Siegmundshof93/kicadPCBs/amurNutzlast/amurNutzlast.kicad_pcb

## KiCad design amurNutzlast/amurNutzlast.kicad_pcb (2023-10-29)

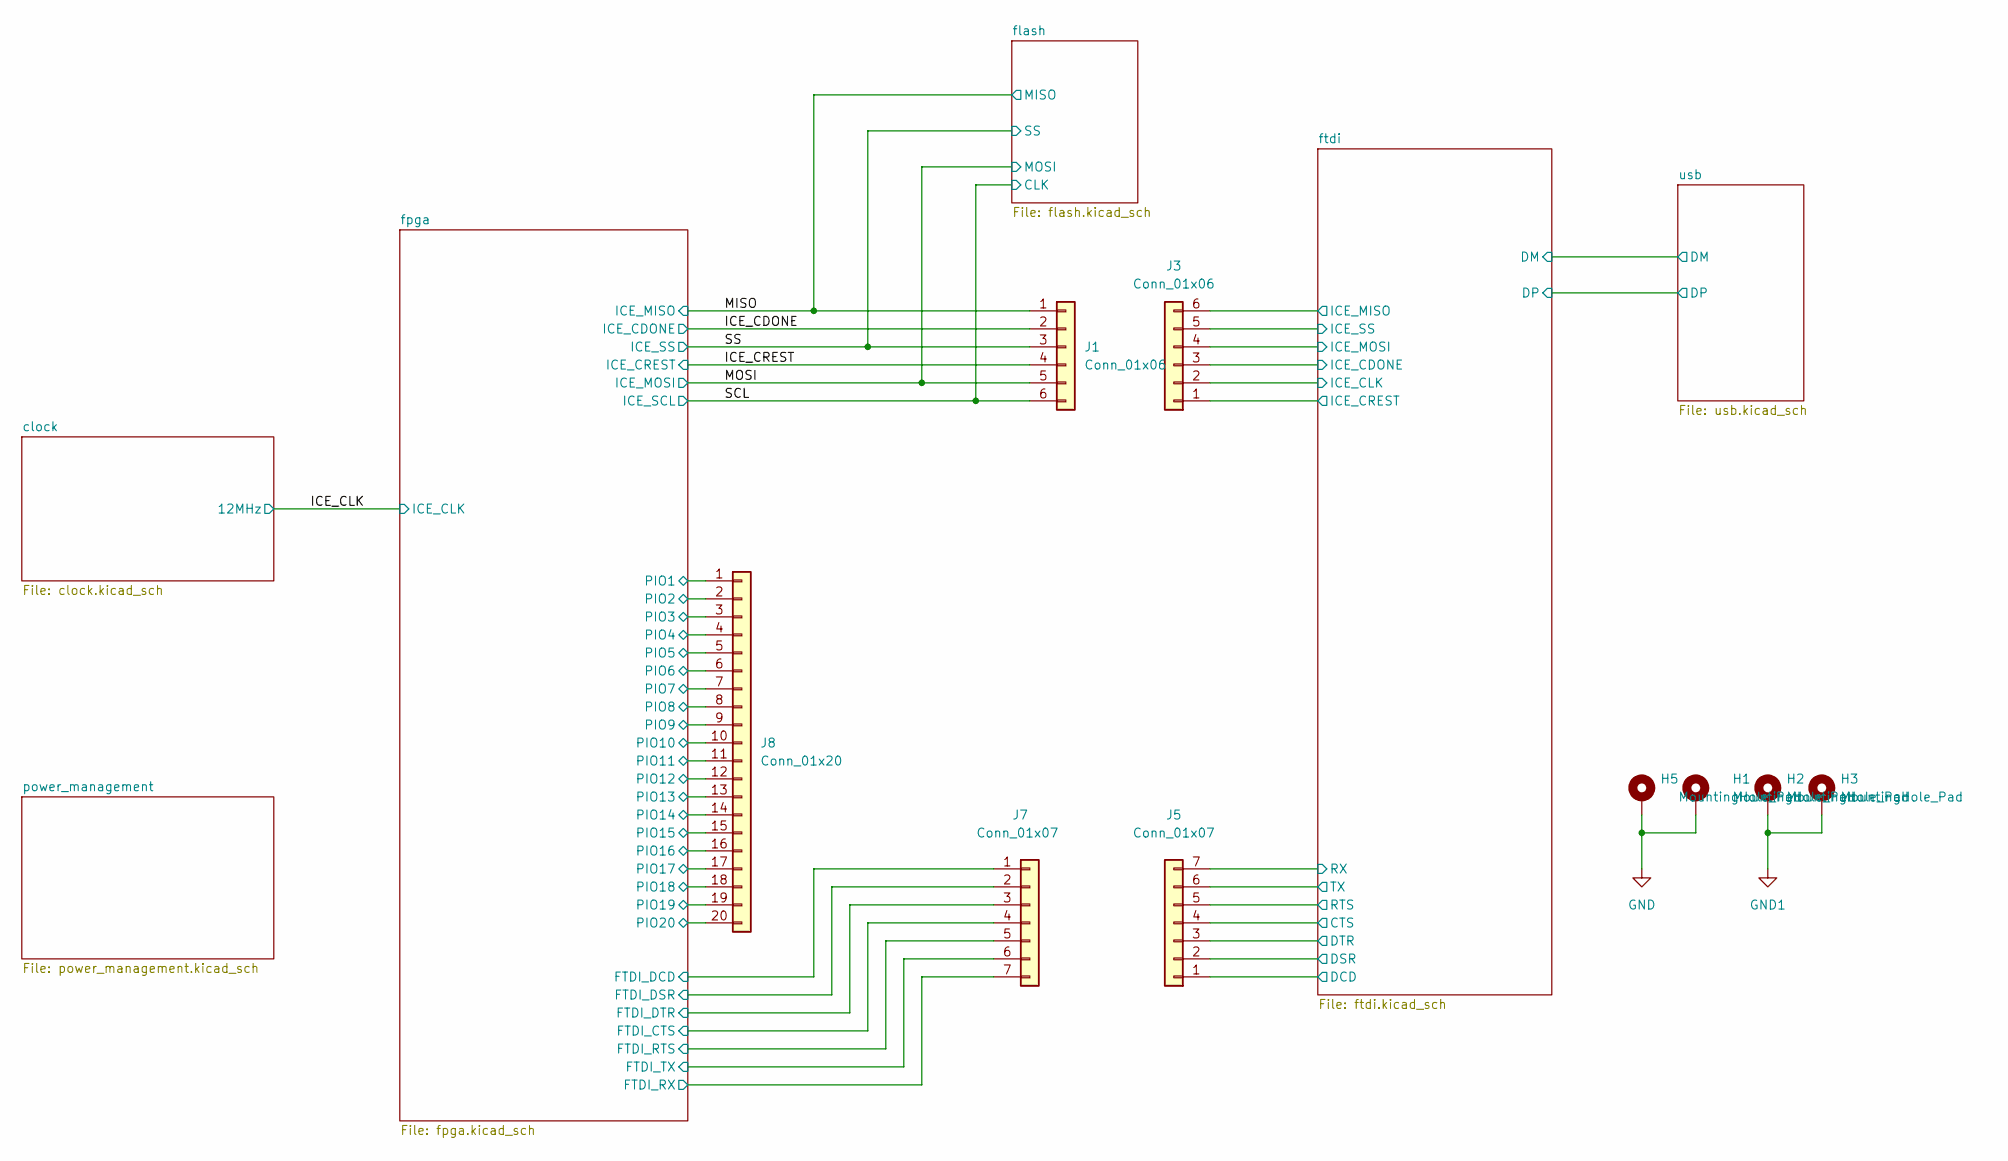
[picture p1: schematic amurNutzlast.kicad_sch]

Parts:
H1, H2, H3, H5: MountingHole_Pad; MountingHole_2.5mm_Pad_Via
J1, J3: Conn_01x06; PinHeader_2x03_P2.54mm_Vertical
J5, J7: Conn_01x07; PinHeader_1x07_P2.54mm_Vertical
J8: Conn_01x20; PinHeader_2x10_P2.54mm_Vertical

Connections:
/ICE_CDONE: J1.2; also elsewhere on the board
/ICE_CREST: J1.4; also elsewhere on the board
/MISO: J1.1; also elsewhere on the board
/MOSI: J1.5; also elsewhere on the board
/SCL: J1.6; also elsewhere on the board
/SS: J1.3; also elsewhere on the board
/fpga/FTDI_CTS: J7.4; also elsewhere on the board
/fpga/FTDI_DCD: J7.1; also elsewhere on the board
/fpga/FTDI_DSR: J7.2; also elsewhere on the board
/fpga/FTDI_DTR: J7.3; also elsewhere on the board
/fpga/FTDI_RTS: J7.5; also elsewhere on the board
/fpga/FTDI_RX: J7.7; also elsewhere on the board
/fpga/FTDI_TX: J7.6; also elsewhere on the board
/fpga/PIO1: J8.1; also elsewhere on the board
/fpga/PIO2: J8.2; also elsewhere on the board
/fpga/PIO3: J8.3; also elsewhere on the board
/fpga/PIO4: J8.4; also elsewhere on the board
/fpga/PIO5: J8.5; also elsewhere on the board
/fpga/PIO6: J8.6; also elsewhere on the board
/fpga/PIO7: J8.7; also elsewhere on the board
/fpga/PIO8: J8.8; also elsewhere on the board
/fpga/PIO9: J8.9; also elsewhere on the board
/fpga/PIO10: J8.10; also elsewhere on the board
/fpga/PIO11: J8.11; also elsewhere on the board
/fpga/PIO12: J8.12; also elsewhere on the board
/fpga/PIO13: J8.13; also elsewhere on the board
/fpga/PIO14: J8.14; also elsewhere on the board
/fpga/PIO15: J8.15; also elsewhere on the board
/fpga/PIO16: J8.16; also elsewhere on the board
/fpga/PIO17: J8.17; also elsewhere on the board
/fpga/PIO18: J8.18; also elsewhere on the board
/fpga/PIO19: J8.19; also elsewhere on the board
/fpga/PIO20: J8.20; also elsewhere on the board
/ftdi/CTS: J5.4; also elsewhere on the board
/ftdi/DCD: J5.1; also elsewhere on the board
/ftdi/DSR: J5.2; also elsewhere on the board
/ftdi/DTR: J5.3; also elsewhere on the board
/ftdi/ICE_CDONE: J3.3; also elsewhere on the board
/ftdi/ICE_CLK: J3.2; also elsewhere on the board
/ftdi/ICE_CREST: J3.1; also elsewhere on the board
/ftdi/ICE_MISO: J3.6; also elsewhere on the board
/ftdi/ICE_MOSI: J3.4; also elsewhere on the board
/ftdi/ICE_SS: J3.5; also elsewhere on the board
/ftdi/RTS: J5.5; also elsewhere on the board
/ftdi/RX: J5.7; also elsewhere on the board
/ftdi/TX: J5.6; also elsewhere on the board

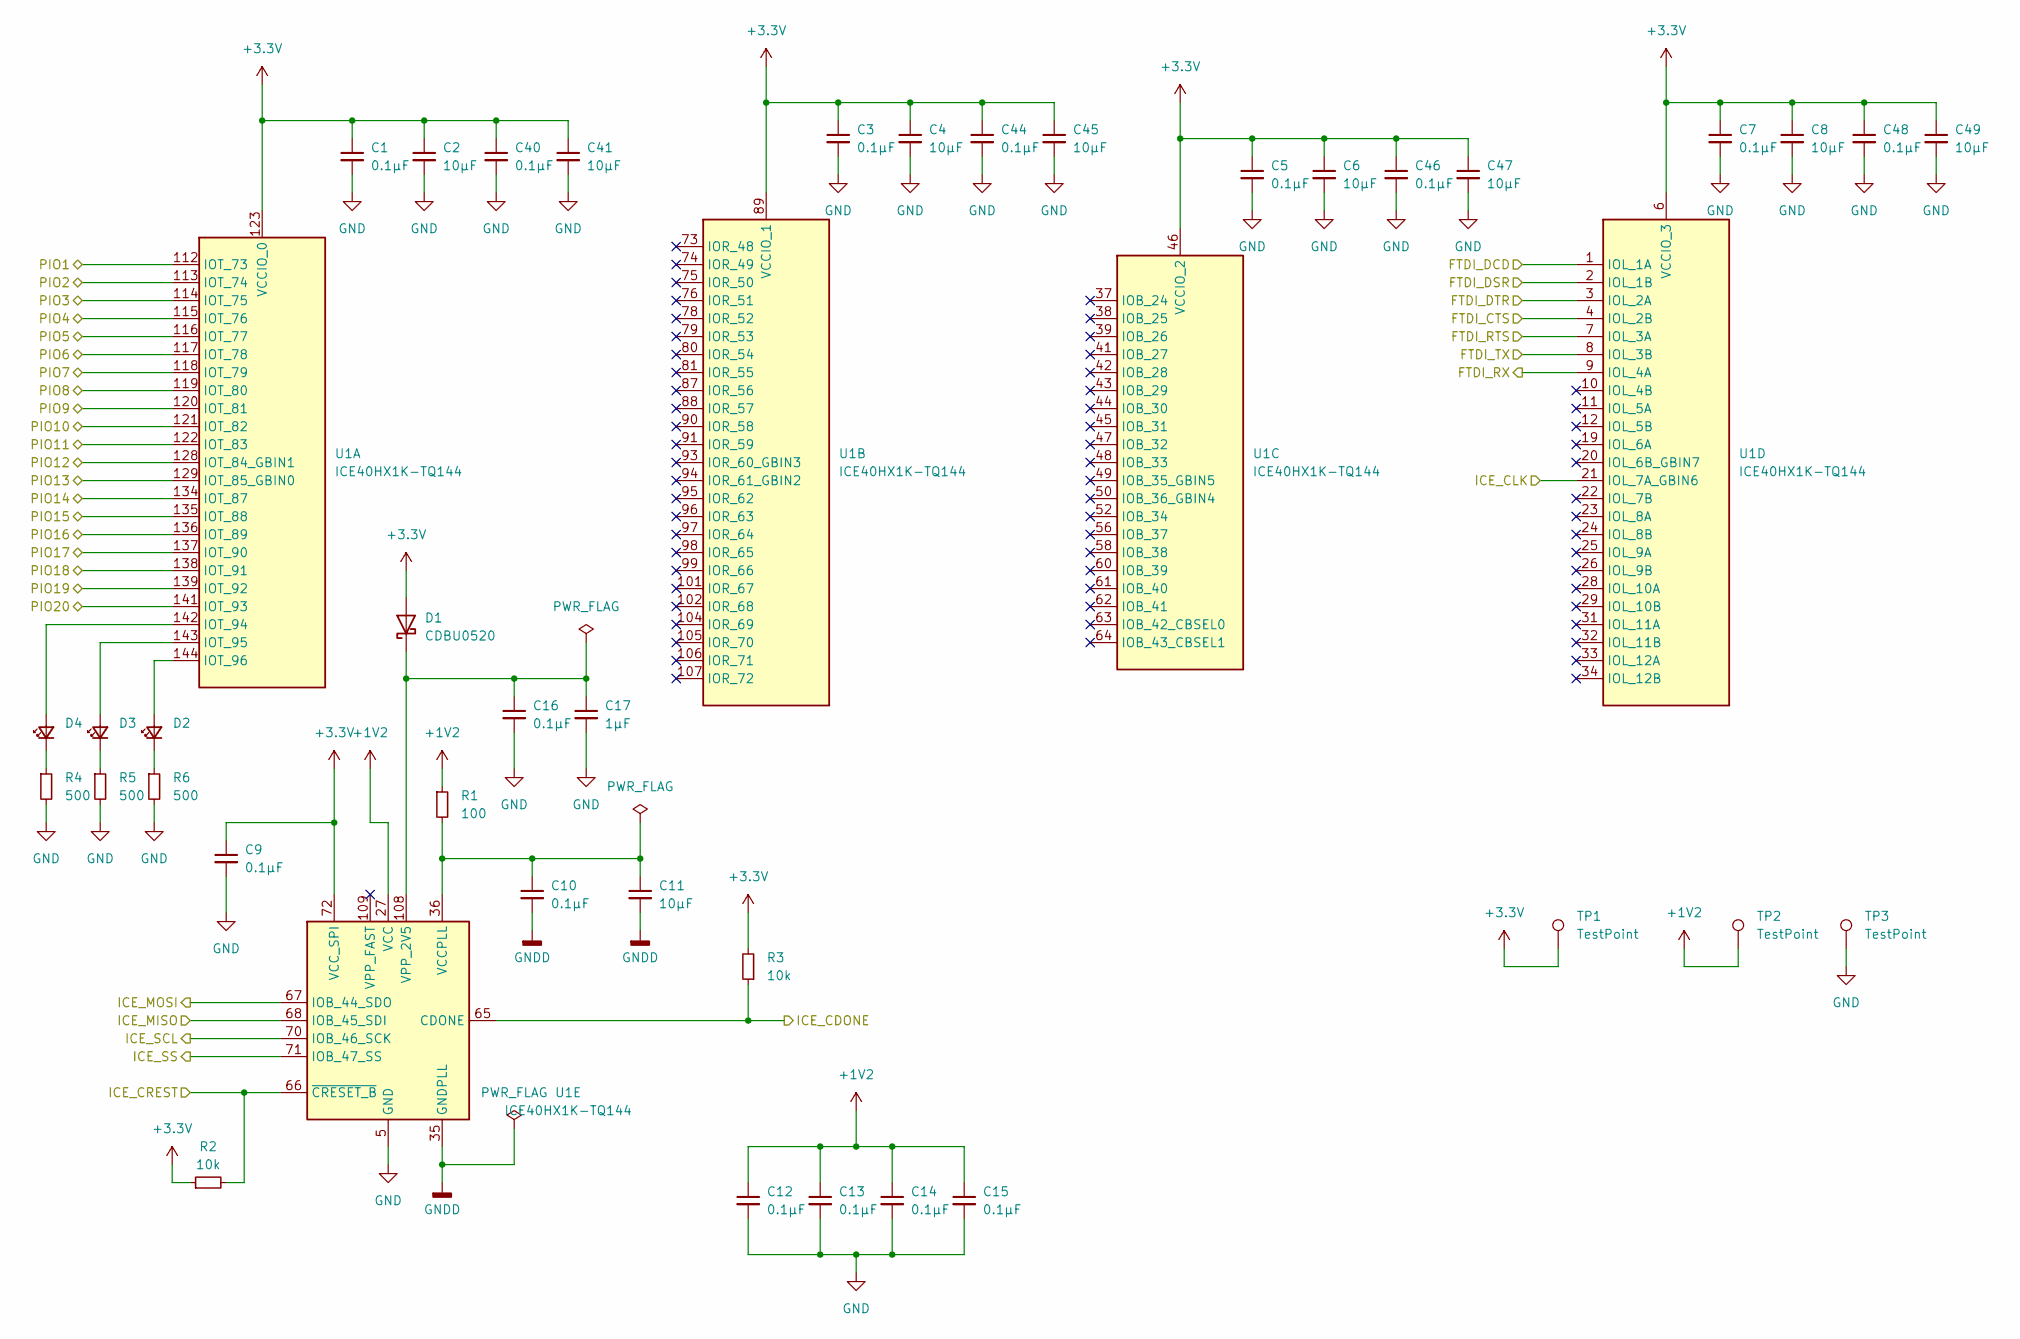
[picture p2: schematic fpga.kicad_sch]

Parts:
C1, C3, C5, C7, C9, C10, C12, C13, C14, C15, C16, C40, C44, C46, C48: 0.1µF; C_0603_1608Metric
C2, C4, C6, C8, C11, C41, C45, C47, C49: 10µF; C_0603_1608Metric
C17: 1µF; C_0603_1608Metric
D1: CDBU0520; D_0603_1608Metric
D2, D3, D4: LED_Small; LED_0603_1608Metric
R1: 100; R_0603_1608Metric
R2, R3: 10k; R_0603_1608Metric
R4, R5, R6: 500; R_0603_1608Metric
TP1, TP2, TP3: TestPoint; TestPoint_Pad_D2.5mm
U1: ICE40HX1K-TQ144; TQFP-144_20x20mm_P0.5mm

Connections:
+1V2: C12.1, C13.1, C14.1, C15.1, R1.1, TP2.1, U1.27 (VCC), U1.51 (VCC), U1.92 (VCC), U1.111 (VCC); also elsewhere on the board
/ICE_CDONE: R3.1, U1.65 (CDONE); also elsewhere on the board
/ICE_CLK: U1.21 (IOL_7A_GBIN6); also elsewhere on the board
/ICE_CREST: R2.2, U1.66 (~CRESET_B); also elsewhere on the board
/MISO: U1.68 (IOB_45_SDI); also elsewhere on the board
/MOSI: U1.67 (IOB_44_SDO); also elsewhere on the board
/SCL: U1.70 (IOB_46_SCK); also elsewhere on the board
/SS: U1.71 (IOB_47_SS); also elsewhere on the board
/fpga/FTDI_CTS: U1.4 (IOL_2B); also elsewhere on the board
/fpga/FTDI_DCD: U1.1 (IOL_1A); also elsewhere on the board
/fpga/FTDI_DSR: U1.2 (IOL_1B); also elsewhere on the board
/fpga/FTDI_DTR: U1.3 (IOL_2A); also elsewhere on the board
/fpga/FTDI_RTS: U1.7 (IOL_3A); also elsewhere on the board
/fpga/FTDI_RX: U1.9 (IOL_4A); also elsewhere on the board
/fpga/FTDI_TX: U1.8 (IOL_3B); also elsewhere on the board
/fpga/PIO1: U1.112 (IOT_73); also elsewhere on the board
/fpga/PIO2: U1.113 (IOT_74); also elsewhere on the board
/fpga/PIO3: U1.114 (IOT_75); also elsewhere on the board
/fpga/PIO4: U1.115 (IOT_76); also elsewhere on the board
/fpga/PIO5: U1.116 (IOT_77); also elsewhere on the board
/fpga/PIO6: U1.117 (IOT_78); also elsewhere on the board
/fpga/PIO7: U1.118 (IOT_79); also elsewhere on the board
/fpga/PIO8: U1.119 (IOT_80); also elsewhere on the board
/fpga/PIO9: U1.120 (IOT_81); also elsewhere on the board
/fpga/PIO10: U1.121 (IOT_82); also elsewhere on the board
/fpga/PIO11: U1.122 (IOT_83); also elsewhere on the board
/fpga/PIO12: U1.128 (IOT_84_GBIN1); also elsewhere on the board
/fpga/PIO13: U1.129 (IOT_85_GBIN0); also elsewhere on the board
/fpga/PIO14: U1.134 (IOT_87); also elsewhere on the board
/fpga/PIO15: U1.135 (IOT_88); also elsewhere on the board
/fpga/PIO16: U1.136 (IOT_89); also elsewhere on the board
/fpga/PIO17: U1.137 (IOT_90); also elsewhere on the board
/fpga/PIO18: U1.138 (IOT_91); also elsewhere on the board
/fpga/PIO19: U1.139 (IOT_92); also elsewhere on the board
/fpga/PIO20: U1.141 (IOT_93); also elsewhere on the board
GNDD: C10.2, C11.2, U1.35 (GNDPLL)
unnamed: C16.1, C17.1, D1.1 (K), U1.108 (VPP_2V5)
unnamed: D2.2 (A), U1.144 (IOT_96)
unnamed: D2.1 (K), R6.1
unnamed: D3.2 (A), U1.143 (IOT_95)
unnamed: D3.1 (K), R5.1
unnamed: D4.2 (A), U1.142 (IOT_94)
unnamed: D4.1 (K), R4.1
unnamed: C10.1, C11.1, R1.2, U1.36 (VCCPLL)

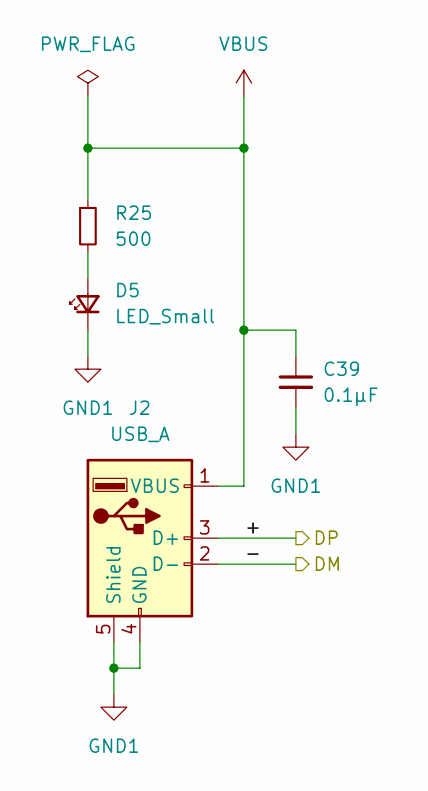
[picture p3: schematic usb.kicad_sch]

Parts:
C39: 0.1µF; C_0603_1608Metric
D5: LED_Small; LED_0603_1608Metric
J2: USB_A; USB_A_CNCTech_1001-011-01101_Horizontal
R25: 500; R_0603_1608Metric

Connections:
+5V: J2.2; also elsewhere on the board

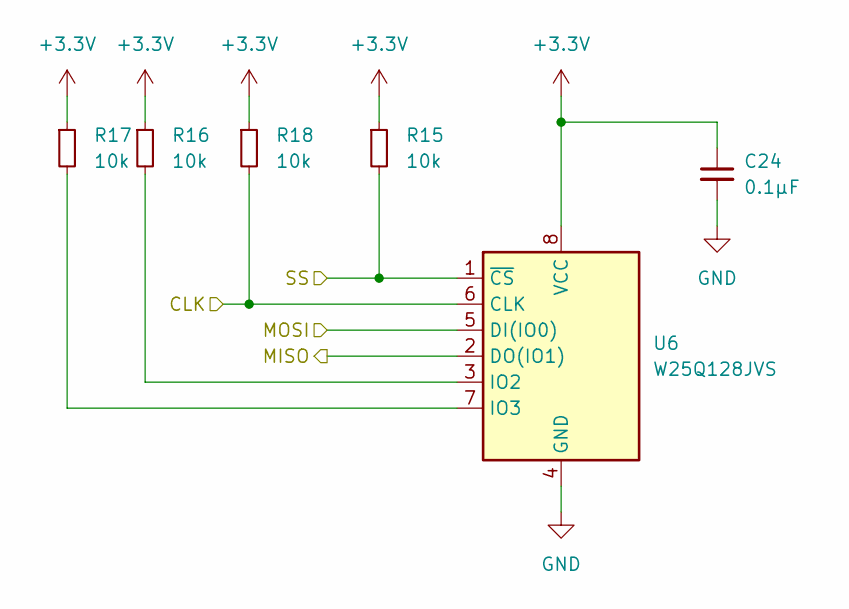
[picture p4: schematic flash.kicad_sch]

Parts:
C24: 0.1µF; C_0603_1608Metric
R15, R16, R17, R18: 10k; R_0603_1608Metric
U6: W25Q128JVS; SOIC-8_5.23x5.23mm_P1.27mm

Connections:
/MISO: U6.2 (DO(IO1)); also elsewhere on the board
/MOSI: U6.5 (DI(IO0)); also elsewhere on the board
/SCL: R18.2, U6.6 (CLK); also elsewhere on the board
/SS: R15.2, U6.1 (~CS); also elsewhere on the board
unnamed: R16.2, U6.3 (IO2)
unnamed: R17.2, U6.7 (IO3)

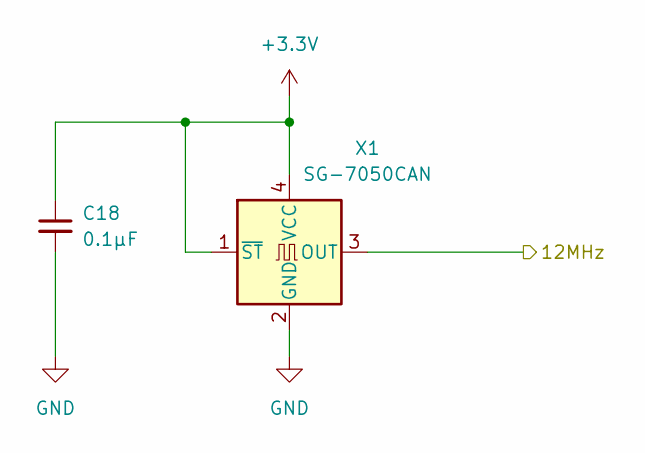
[picture p5: schematic clock.kicad_sch]

Parts:
C18: 0.1µF; C_0603_1608Metric
X1: SG-7050CAN; Oscillator_SMD_SeikoEpson_SG8002CA-4Pin_7.0x5.0mm

Connections:
/ICE_CLK: X1.3 (OUT); also elsewhere on the board

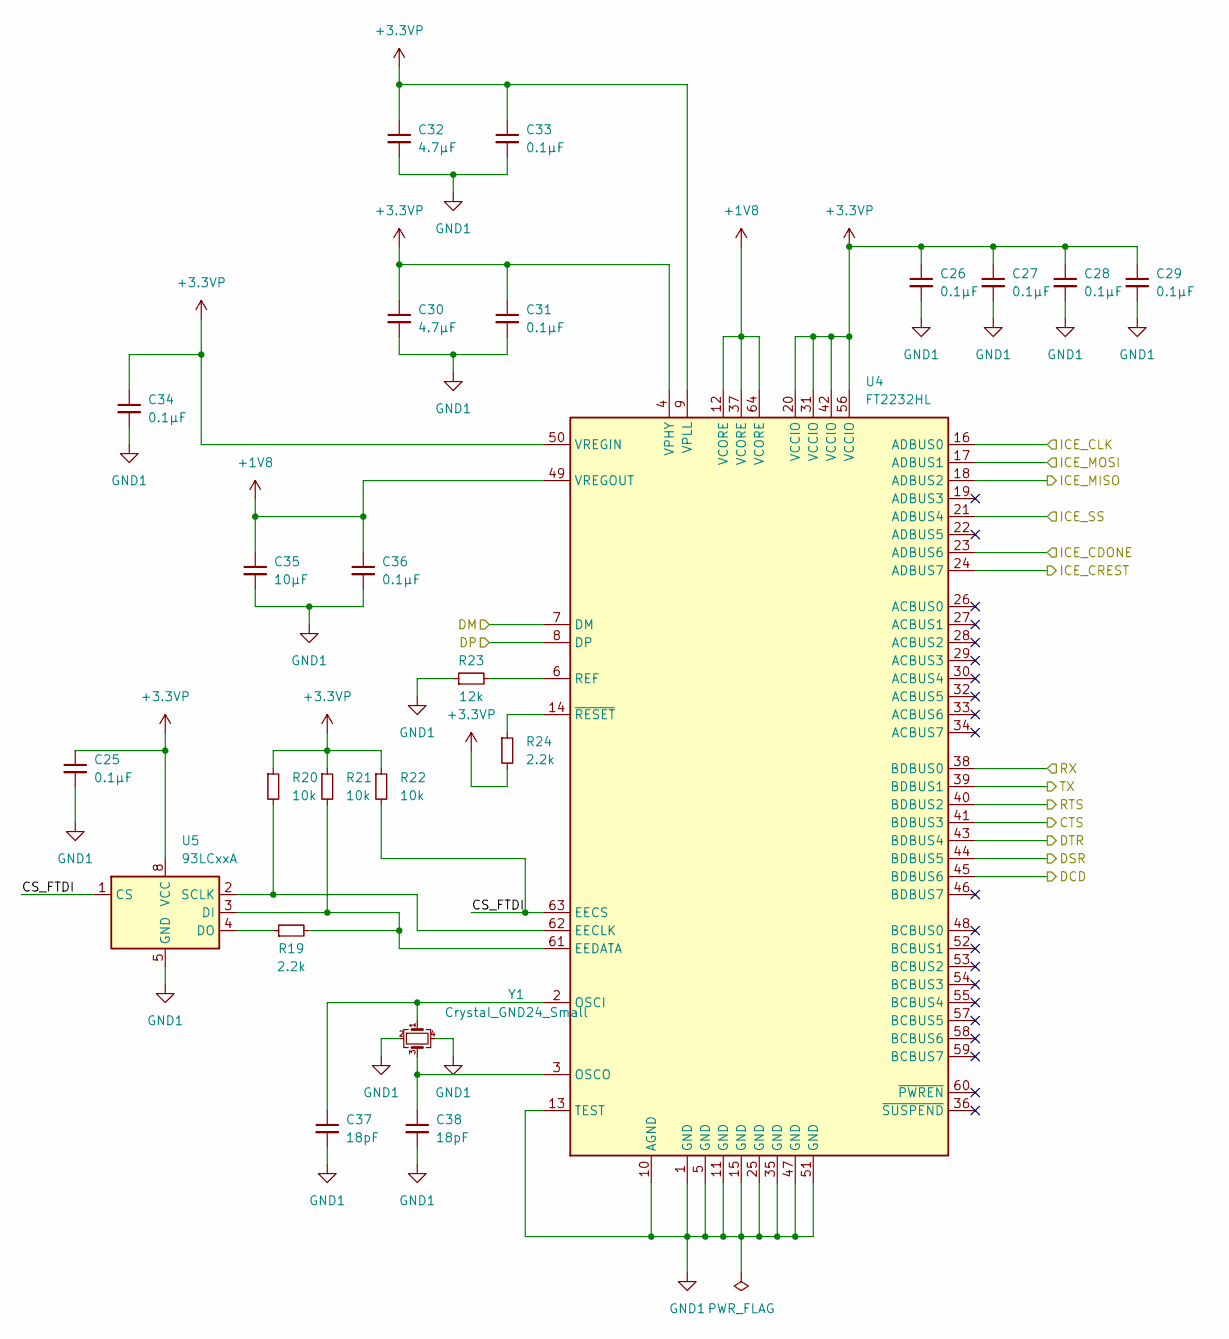
[picture p6: schematic ftdi.kicad_sch]

Parts:
C25, C26, C27, C28, C29, C31, C33, C34, C36: 0.1µF; C_0603_1608Metric
C30, C32: 4.7µF; C_0603_1608Metric
C35: 10µF; C_0603_1608Metric
C37, C38: 18pF; C_0603_1608Metric
R19, R24: 2.2k; R_0603_1608Metric
R20, R21, R22: 10k; R_0603_1608Metric
R23: 12k; R_0603_1608Metric
U4: FT2232HL; LQFP-64_10x10mm_P0.5mm
U5: 93LCxxA; SOIC-8_3.9x4.9mm_P1.27mm
Y1: Crystal_GND24_Small; Crystal_SMD_3225-4Pin_3.2x2.5mm

Connections:
+1V8: C35.1, C36.1, U4.12 (VCORE), U4.37 (VCORE), U4.49 (VREGOUT), U4.64 (VCORE)
/ftdi/CS_FTDI: R22.2, U4.63 (EECS), U5.1 (CS)
/ftdi/CTS: U4.41 (BDBUS3); also elsewhere on the board
/ftdi/DCD: U4.45 (BDBUS6); also elsewhere on the board
/ftdi/DSR: U4.44 (BDBUS5); also elsewhere on the board
/ftdi/DTR: U4.43 (BDBUS4); also elsewhere on the board
/ftdi/ICE_CDONE: U4.23 (ADBUS6); also elsewhere on the board
/ftdi/ICE_CLK: U4.16 (ADBUS0); also elsewhere on the board
/ftdi/ICE_CREST: U4.24 (ADBUS7); also elsewhere on the board
/ftdi/ICE_MISO: U4.18 (ADBUS2); also elsewhere on the board
/ftdi/ICE_MOSI: U4.17 (ADBUS1); also elsewhere on the board
/ftdi/ICE_SS: U4.21 (ADBUS4); also elsewhere on the board
/ftdi/RTS: U4.40 (BDBUS2); also elsewhere on the board
/ftdi/RX: U4.38 (BDBUS0); also elsewhere on the board
/ftdi/TX: U4.39 (BDBUS1); also elsewhere on the board
/usb/+: U4.8 (DP); also elsewhere on the board
/usb/-: U4.7 (DM); also elsewhere on the board
unnamed: R20.2, U4.62 (EECLK), U5.2 (SCLK)
unnamed: R19.2, R21.2, U4.61 (EEDATA), U5.3 (DI)
unnamed: C37.1, U4.2 (OSCI), Y1.1
unnamed: C38.1, U4.3 (OSCO), Y1.3
unnamed: R23.2, U4.6 (REF)
unnamed: R24.1, U4.14 (~RESET)
unnamed: R19.1, U5.4 (DO)

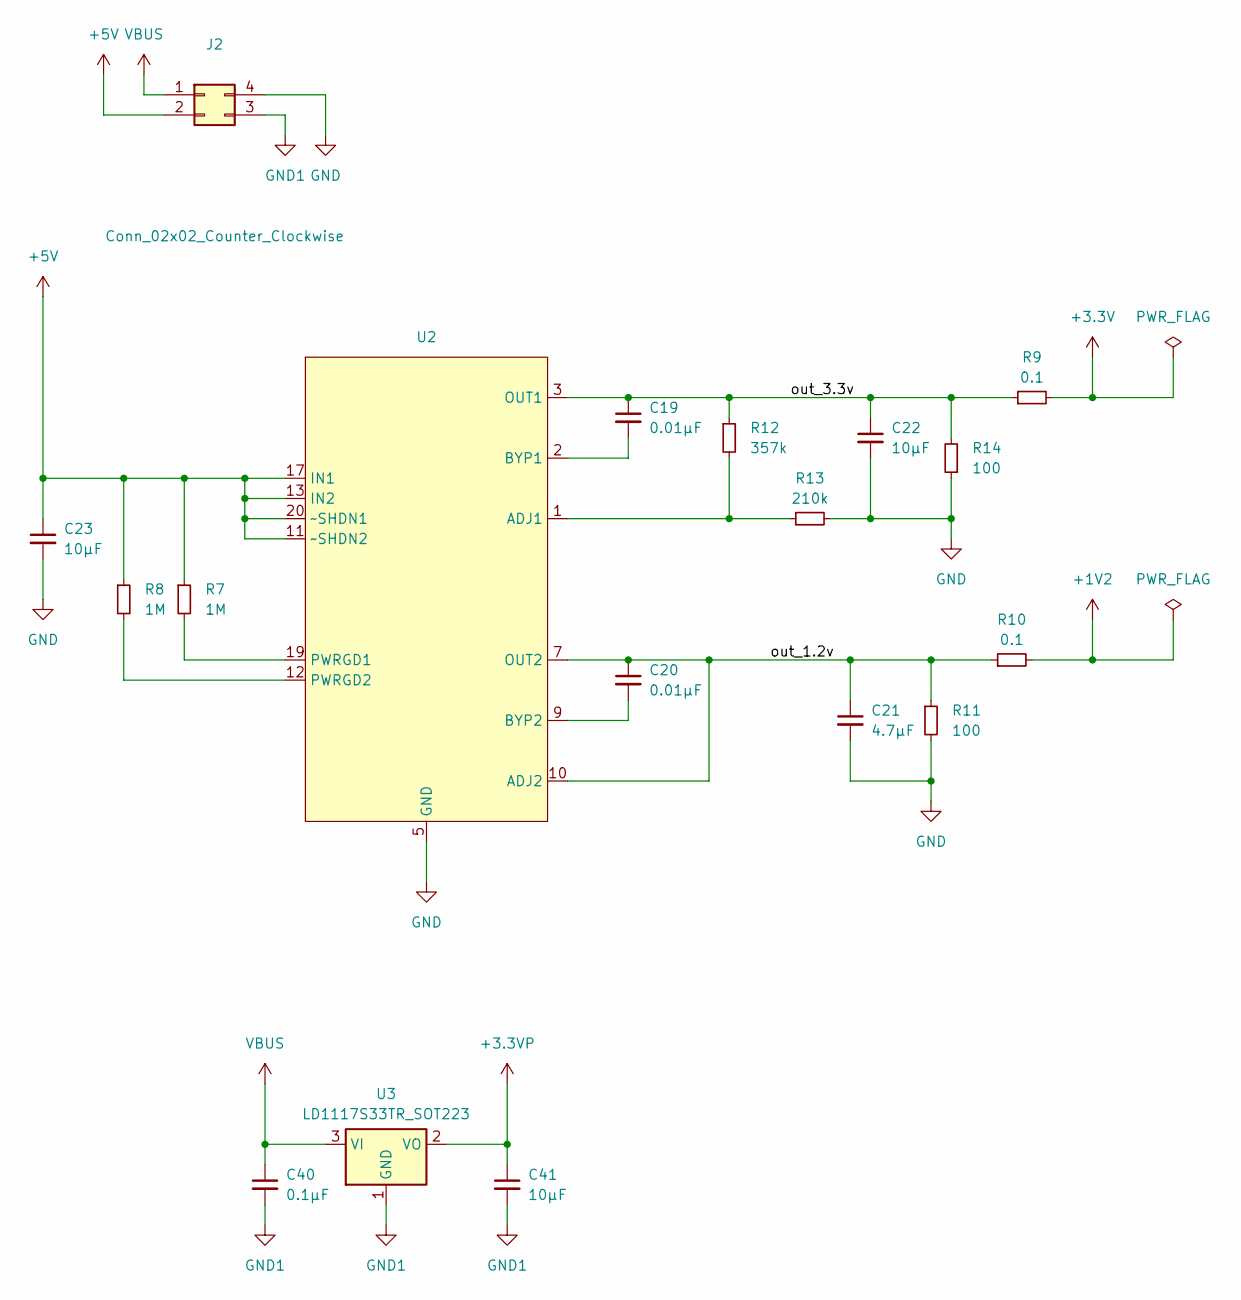
[picture p7: schematic power_management.kicad_sch]

Parts:
C19, C20: 0.01µF; C_0603_1608Metric
C21: 4.7µF; C_0603_1608Metric
C22, C23, C41: 10µF; C_0603_1608Metric
C40: 0.1µF; C_0603_1608Metric
J2: Conn_02x02_Counter_Clockwise; PinHeader_2x02_P2.54mm_Vertical
R7, R8: 1M; R_0603_1608Metric
R9, R10: 0.1; R_0603_1608Metric
R11, R14: 100; R_0603_1608Metric
R12: 357k; R_0603_1608Metric
R13: 210k; R_0603_1608Metric
U2: HTSSOP-20-1EP_4.4x6.5mm_P0.65mm_EP2.74x3.86mm
U3: LD1117S33TR_SOT223; SOT-223-3_TabPin2

Connections:
+1V2: R10.2; also elsewhere on the board
+5V: C23.1, J2.2, R7.1, R8.1, U2.11 (~SHDN2), U2.13 (IN2), U2.14 (IN2), U2.17 (IN1), U2.18 (IN1), U2.20 (~SHDN1)
/power_management/out_1.2v: C20.1, C21.1, R10.1, R11.1, U2.7 (OUT2), U2.8 (OUT2), U2.10 (ADJ2)
/power_management/out_3.3v: C19.1, C22.1, R9.1, R12.1, R14.2, U2.3 (OUT1), U2.4 (OUT1)
unnamed: R12.2, R13.1, U2.1 (ADJ1)
unnamed: C19.2, U2.2 (BYP1)
unnamed: C20.2, U2.9 (BYP2)
unnamed: R7.2, U2.19 (PWRGD1)
unnamed: R8.2, U2.12 (PWRGD2)

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
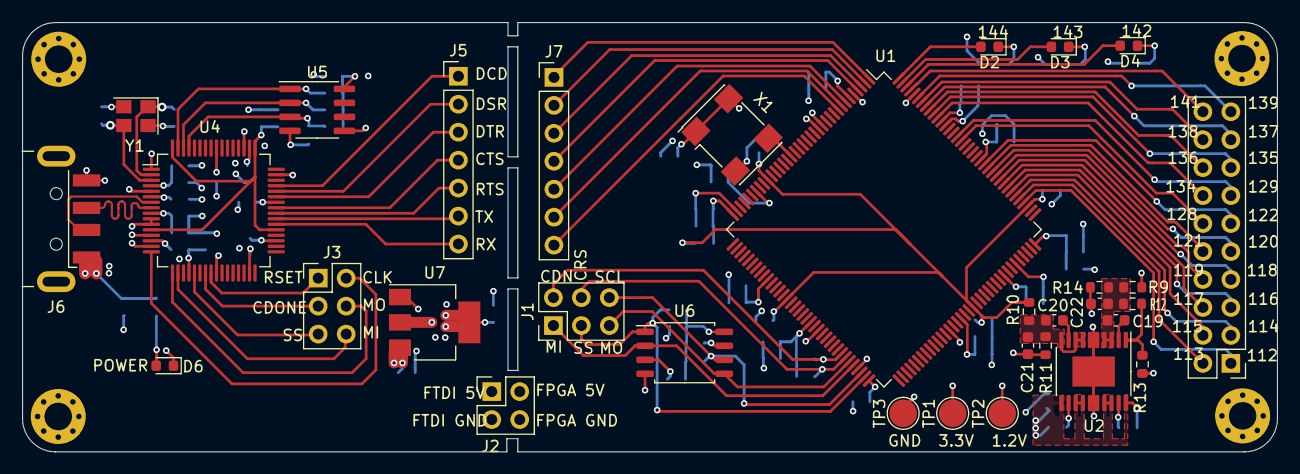
[picture p8: board amurNutzlast.kicad_pcb from above]

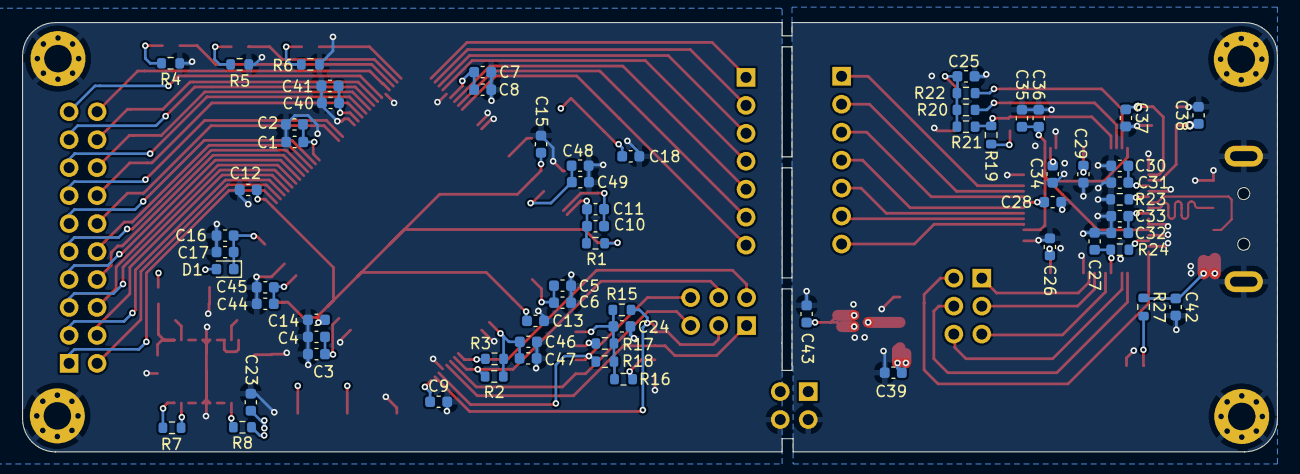
[picture p9: board amurNutzlast.kicad_pcb from below]

Board: 4 copper layers, 114.0 x 39.0 mm, 101 parts (65 on the bottom side), 84 nets.

Other parts of the board:
C42: 0.1µF; C_0603_1608Metric
C43: 10µF; C_0603_1608Metric
D6: LED_Small; LED_0603_1608Metric
J6: USB_A; USB_A_CNCTech_1001-011-01101_Horizontal
R27: 500; R_0603_1608Metric
U7: LD1117S33TR_SOT223; SOT-223-3_TabPin2

Their connections:
/usb/+: J6.3 (D+); also elsewhere on the board
/usb/-: J6.2 (D-); also elsewhere on the board
unnamed: D6.2 (A), R27.2
