Siegmundshof93/kicadPCBs/(commit log)

2023-10-15 Fpga chip only
    [amurNutzlast.kicad_pcb, amurNutzlast.kicad_sch, fpga.kicad_sch]
2023-10-15 working on the FTDI design in kicad FPGA prototype board
    [amurNutzlast.kicad_sch, clock.kicad_sch, flash.kicad_sch, fpga.kicad_sch, ftdi.kicad_sch, power_management.kicad_sch]
2023-10-16 ftdi schematic was added apart of the USB
    [amurNutzlast.kicad_sch, fpga.kicad_sch, ftdi.kicad_sch]
2023-10-17 finisched design schematics + pdf
    [amurNutzlast.kicad_sch, flash.kicad_sch, fpga.kicad_sch, ftdi.kicad_sch, power_management.kicad_sch]
2023-10-19 layout start
    [amurNutzlast.kicad_pcb, amurNutzlast.kicad_sch, clock.kicad_sch, flash.kicad_sch, fpga.kicad_sch, ftdi.kicad_sch, power_management.kicad_sch]
2023-10-20 deleted 3.3 converter for ftdi and moved USB to a hierarhical sheet
    [amurNutzlast.kicad_pcb, amurNutzlast.kicad_sch, ftdi.kicad_sch, power_management.kicad_sch, usb.kicad_sch]
2023-10-22 layout ftdi placement
    [amurNutzlast.kicad_pcb, amurNutzlast.kicad_sch, power_management.kicad_sch]
2023-10-22 ftdi layout continuation
    [amurNutzlast.kicad_pcb, amurNutzlast.kicad_sch, ftdi.kicad_sch, usb.kicad_sch]
2023-10-24 ftdi layout finish
    [amurNutzlast.kicad_pcb, amurNutzlast.kicad_sch, ftdi.kicad_sch]
2023-10-25 started FPGA
    [amurNutzlast.kicad_pcb, amurNutzlast.kicad_sch, fpga.kicad_sch]
2023-10-26 placement finished
    [amurNutzlast.kicad_pcb, amurNutzlast.kicad_sch, fpga.kicad_sch, power_management.kicad_sch]
2023-10-29 gpio connected
    [amurNutzlast.kicad_pcb, power_management.kicad_sch]
2023-10-29 finished pcb
    [amurNutzlast-B_Cu.gbr, amurNutzlast-B_Mask.gbr, amurNutzlast-B_Paste.gbr, amurNutzlast-B_Silkscreen.gbr, amurNutzlast-Edge_Cuts.gbr, amurNutzlast-F_Cu.gbr, amurNutzlast-F_Mask.gbr, amurNutzlast-F_Paste.gbr]
